morlac/helios_display/FreeCAD/HeliosDisplayStand-Proto_RaspiBody.stl

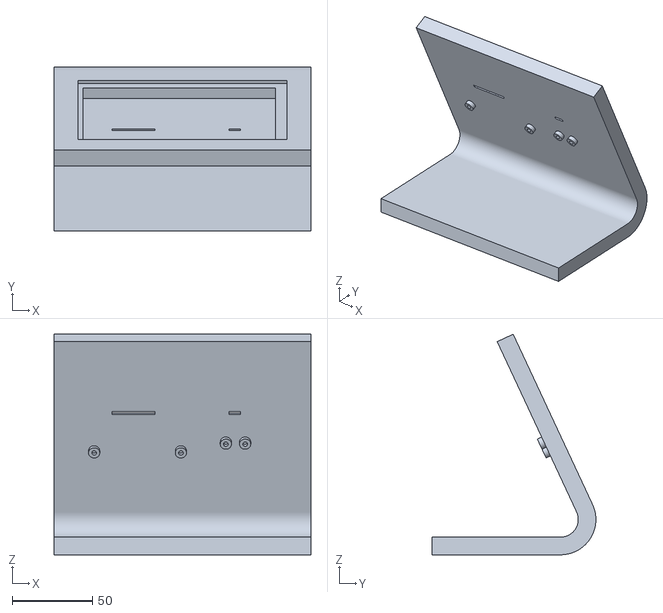
[picture p1: CAD file, 2022-06-07]
FreeCAD/HeliosDisplayStand-Proto_RaspiBody.stl
160.0 x 102.0 x 137.3
