morlac/helios_display/FreeCAD/HeliosDisplayStand.FCStd

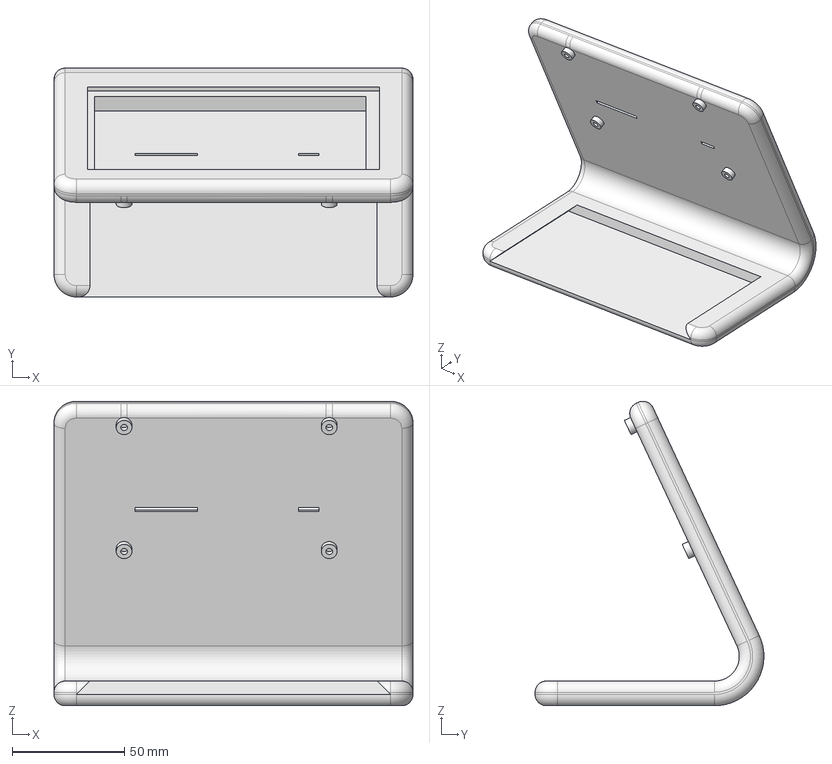
[picture p2: CAD file, 2022-06-07]
FreeCAD/HeliosDisplayStand.FCStd
160.0 x 102.0 x 135.7 mm
