morlac/helios_display/FreeCAD/HeliosDisplayStand-Electronics-BaseRaspi_2+.stl

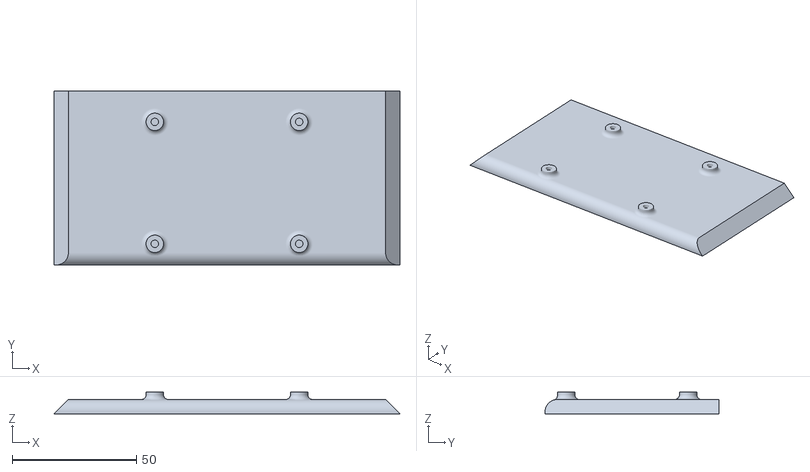
[picture p3: CAD file, 2022-06-07]
FreeCAD/HeliosDisplayStand-Electronics-BaseRaspi_2+.stl
139.0 x 69.9 x 8.80
