morlac/helios_display/KiCAD/Download_WE-PD_1280_STP (rev1).stp

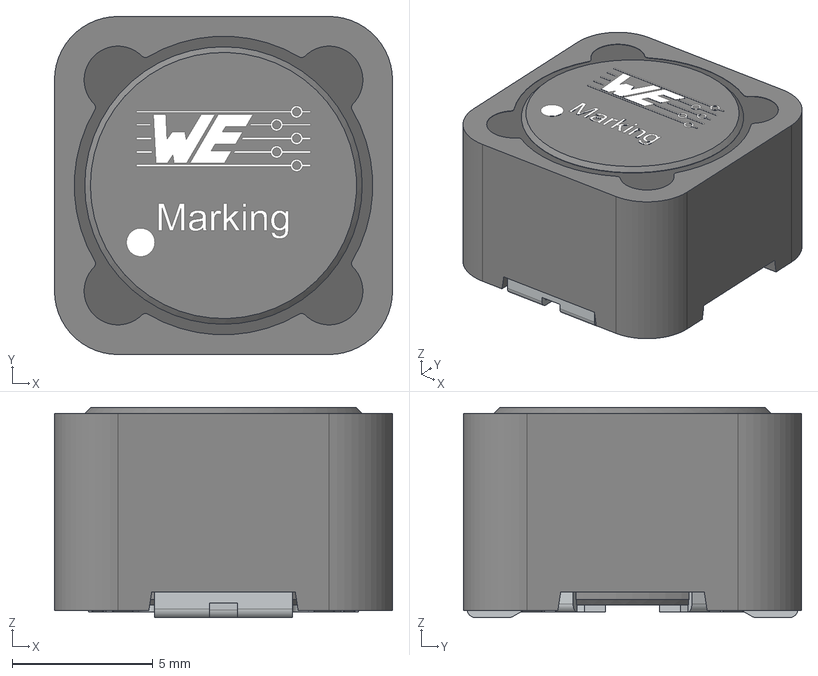
[picture p4: CAD file, 2022-06-07]
KiCAD/Download_WE-PD_1280_STP (rev1).stp
12.0 x 12.0 x 7.46 mm
Core
ShieldRing
Glue
Leadframe
