morlac/helios_display/FreeCAD/TestRig.FCStd

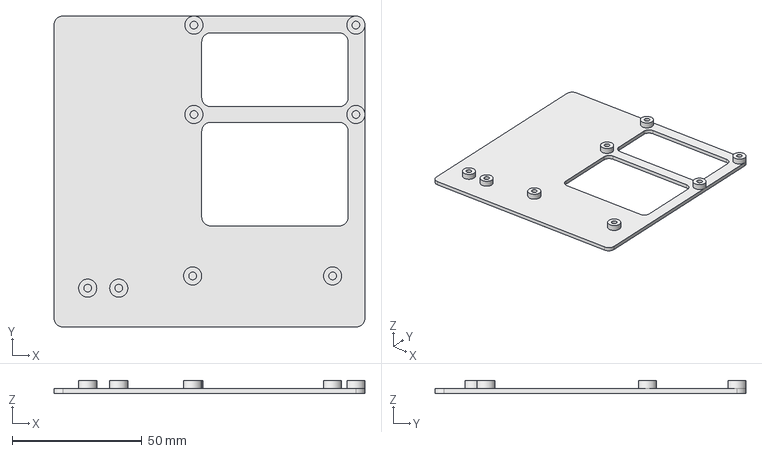
[picture p5: CAD file, 2022-02-08]
FreeCAD/TestRig.FCStd
120.0 x 120.0 x 5.00 mm
