morlac/helios_display/FreeCAD/TestRig-PartBasePlate.stl

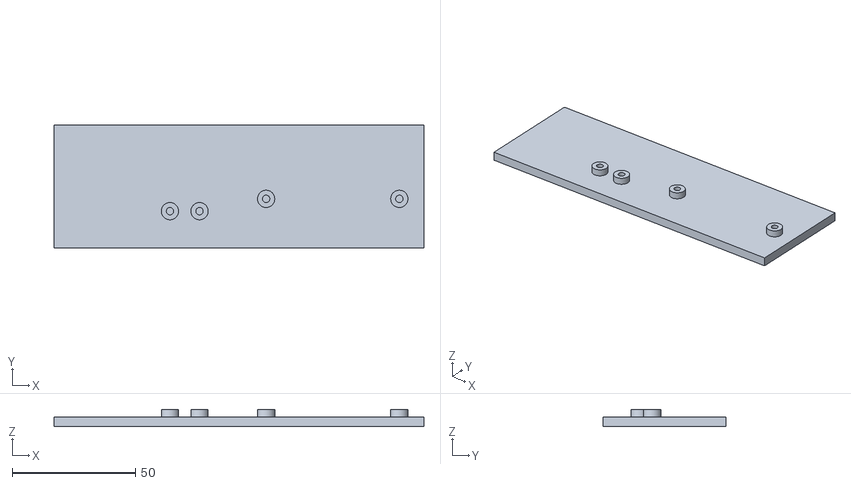
[picture p6: CAD file, 2022-02-08]
FreeCAD/TestRig-PartBasePlate.stl
150.0 x 50.0 x 7.00
