morlac/helios_display/KiCAD/687145149022 (rev1).stp

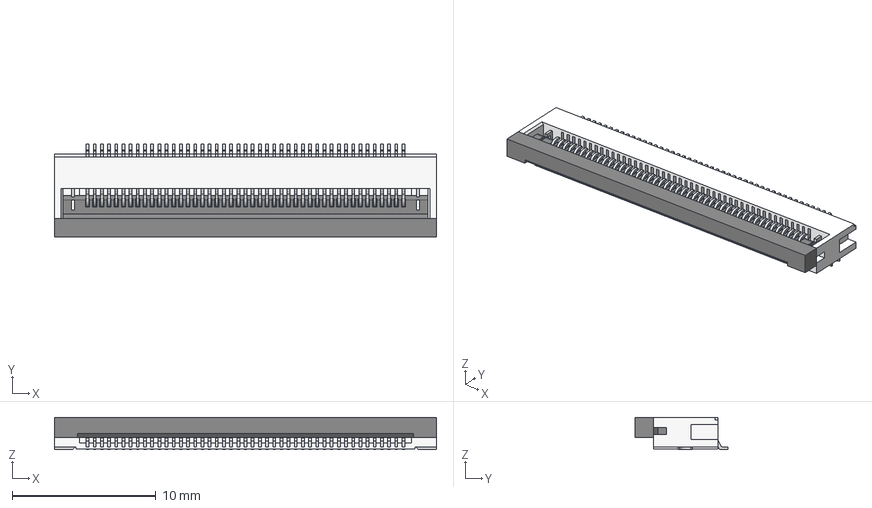
[picture p7: CAD file, 2022-06-07]
KiCAD/687145149022 (rev1).stp
26.6 x 6.50 x 2.25 mm
6871xx149022_Pin x 45
6871xx149022_Patte
6871xx149022_Patte2
687145149022_Actuator
