morlac/helios_display/KiCAD/687106149022 (rev1).stp

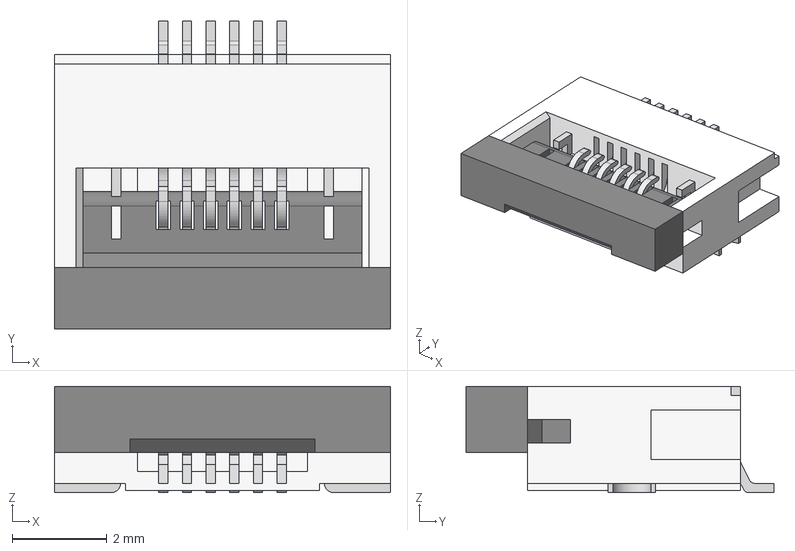
[picture p8: CAD file, 2022-06-07]
KiCAD/687106149022 (rev1).stp
7.10 x 6.50 x 2.25 mm
6871xx149022_Pin x 6
6871xx149022_Patte
6871xx149022_Patte2
687106149022_Actuator
