morlac/helios_display/(list of files, cad)

Other CAD files:
FreeCAD/HeliosDisplayStand-Electronics-BaseRaspi_Zero.stl
FreeCAD/HeliosDisplayStand-StandBody.stl
FreeCAD/TestRig-DevBoard.stl
FreeCAD/HeliosDisplayStand-Proto_Raspi.stl
