morlac/helios_display/(list of files, drawings)

Other design files:
KiCAD/Helios-Display.dsn
