morlac/helios_display/KiCAD/Helios-Display.kicad_pcb

## KiCad design KiCAD/Helios-Display.kicad_pcb (2022-06-07)

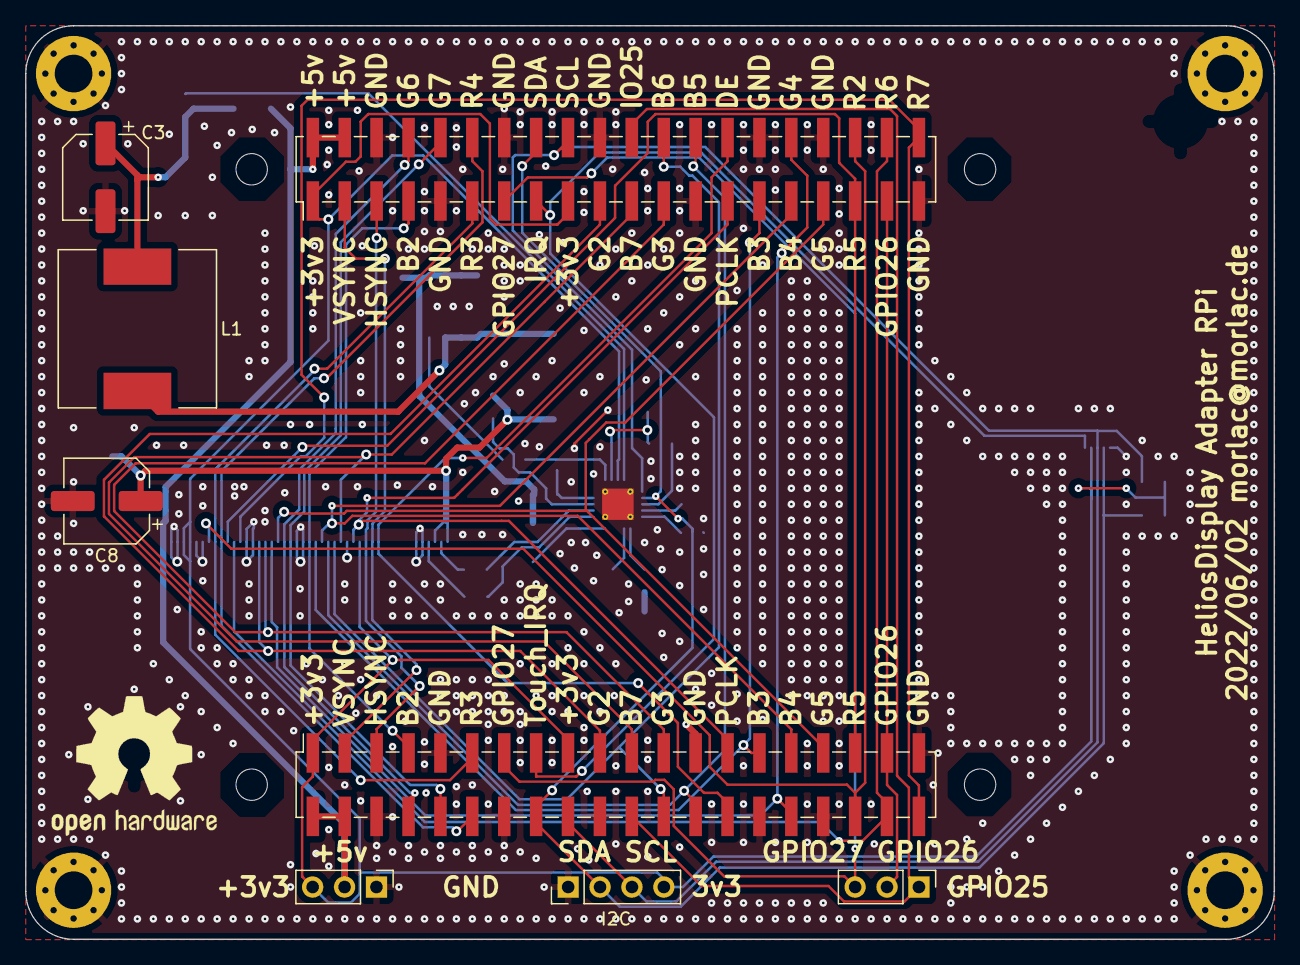
[picture p9: board Helios-Display.kicad_pcb from above]

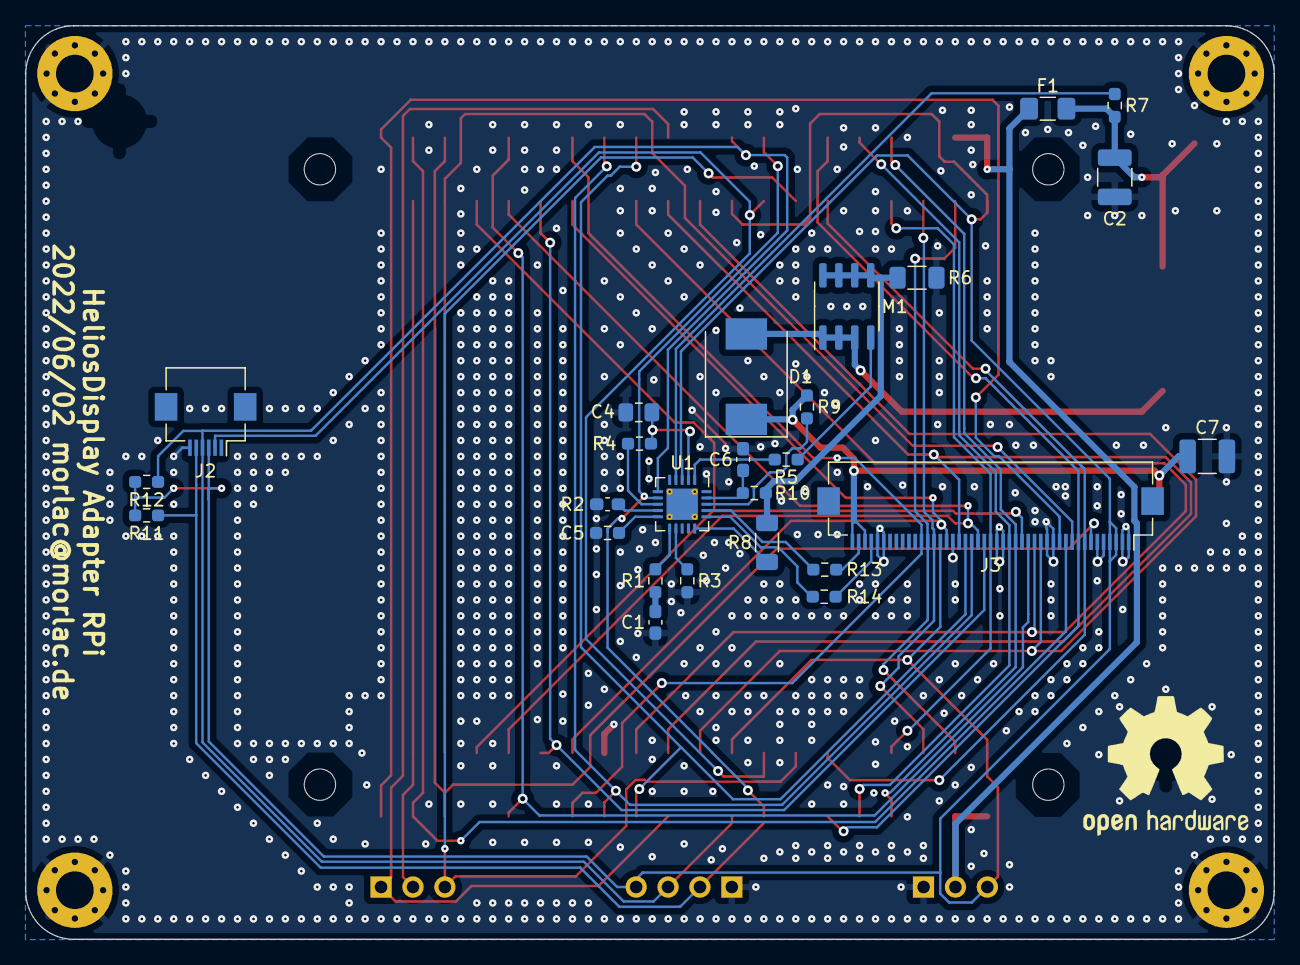
[picture p10: board Helios-Display.kicad_pcb from below]

Board: 2 copper layers, 99.4 x 72.7 mm, 44 parts (27 on the bottom side), 52 nets.

Parts:
C1: 470nF; C_0603_1608Metric_Pad1.08x0.95mm_HandSolder
C2: 4.7uF/16V; C_1210_3225Metric_Pad1.33x2.70mm_HandSolder
C3: 220uF/16V; CP_Elec_6.3x3
C4: 0.47uF; C_0805_2012Metric_Pad1.18x1.45mm_HandSolder
C5: 100nF; C_0603_1608Metric_Pad1.08x0.95mm_HandSolder
C6: NC; C_0603_1608Metric_Pad1.08x0.95mm_HandSolder
C7: 4.7uF/25V; C_1210_3225Metric_Pad1.33x2.70mm_HandSolder
C8: 22uF/25V; CP_Elec_6.3x3
D1: B360; D_SMC
F1: Fuse; Fuse_1206_3216Metric_Pad1.42x1.75mm_HandSolder
H1, H2, H3, H4: MountingHole_Pad; MountingHole_3mm_Pad_Via
H5, H6, H7, H8: MountingHoleRaspi; MountingHole_2.5mm
J1, J8: Raspberry_Pi_2_3; PinHeader_2x20_P2.54mm_Vertical_SMD
J2: FFC_ST1633 (Touch); Hirose_FH12-6S-0.5SH_1x06-1MP_P0.50mm_Horizontal
J3: FFC_LCD; Hirose_FH12-45S-0.5SH_1x45-1MP_P0.50mm_Horizontal
J4: Power; PinHeader_1x03_P2.54mm_Vertical
J6: I2C; PinHeader_1x04_P2.54mm_Vertical
J7: GPIO; PinHeader_1x03_P2.54mm_Vertical
L1: 33uH/3.5A; L_12x12mm_H8mm
M1: AM4490N; SOIC-8_3.9x4.9mm_P1.27mm
OSHW_F: OSHW-Logo2_14.6x12mm_SilkScreen
OSJW_B: OSHW-Logo2_14.6x12mm_SilkScreen
R1: 270; R_0603_1608Metric_Pad0.98x0.95mm_HandSolder
R2, R4: 100k; R_0603_1608Metric_Pad0.98x0.95mm_HandSolder
R3: R; R_0603_1608Metric_Pad0.98x0.95mm_HandSolder
R5: 10; R_0603_1608Metric_Pad0.98x0.95mm_HandSolder
R6: 50m; R_1206_3216Metric_Pad1.30x1.75mm_HandSolder
R7, R9, R10, R13, R14: 0; R_0603_1608Metric_Pad0.98x0.95mm_HandSolder
R8: NC; R_1206_3216Metric_Pad1.30x1.75mm_HandSolder
R11, R12: 50; R_0603_1608Metric_Pad0.98x0.95mm_HandSolder
U1: MP3385A; QFN-20-1EP_4x4mm_P0.5mm_EP2.5x2.5mm_ThermalVias

Connections:
+3V3: J1.1 (3V3), J1.17 (3V3), J2.3, J3.3, J3.4, J3.31, J4.3, J6.4, J8.1 (3V3), J8.17 (3V3), R11.2, R12.2, U1.3 (EN)
+5V: F1.1, J1.2 (5V), J1.4 (5V), J4.2, J8.2 (5V), J8.4 (5V)
/GPIO25: J1.22 (GPIO25), J7.1, J8.22 (GPIO25)
/GPIO26: J1.37 (GPIO26), J7.2, J8.37 (GPIO26)
/GPIO27: J1.13 (GPIO27), J7.3, J8.13 (GPIO27)
/GPIO_SCL: J1.18 (GPIO24), J2.4, J6.3, J8.18 (GPIO24), R12.1, U1.6 (SCL)
/GPIO_SDA: J1.16 (GPIO23), J2.5, J6.2, J8.16 (GPIO23), R11.1, U1.7 (SDA)
/LCD_B_{2}: J1.7 (GCLK0/GPIO4), J3.23, J8.7 (GCLK0/GPIO4)
/LCD_B_{3}: J1.29 (GCLK1/GPIO5), J3.24, J8.29 (GCLK1/GPIO5)
/LCD_B_{4}: J1.31 (GCLK2/GPIO6), J3.25, J8.31 (GCLK2/GPIO6)
/LCD_B_{5}: J1.26 (~CE1/GPIO7), J3.26, J8.26 (~CE1/GPIO7)
/LCD_B_{6}: J1.24 (~CE0/GPIO8), J3.27, J8.24 (~CE0/GPIO8)
/LCD_B_{7}: J1.21 (MISO0/GPIO9), J3.28, J8.21 (MISO0/GPIO9)
/LCD_DE: J1.28 (ID_SC/GPIO1), J3.34, J8.28 (ID_SC/GPIO1)
/LCD_G_{2}: J1.19 (MOSI0/GPIO10), J3.15, J8.19 (MOSI0/GPIO10)
/LCD_G_{3}: J1.23 (SCLK0/GPIO11), J3.16, J8.23 (SCLK0/GPIO11)
/LCD_G_{4}: J1.32 (PWM0/GPIO12), J3.17, J8.32 (PWM0/GPIO12)
/LCD_G_{5}: J1.33 (PWM1/GPIO13), J3.18, J8.33 (PWM1/GPIO13)
/LCD_G_{6}: J1.8 (GPIO14/TXD), J3.19, J8.8 (GPIO14/TXD)
/LCD_G_{7}: J1.10 (GPIO15/RXD), J3.20, J8.10 (GPIO15/RXD)
/LCD_HSYNC: J1.5 (SCL/GPIO3), J3.32, J8.5 (SCL/GPIO3)
/LCD_LED_A1: C7.1, C8.1, D1.1 (K), J3.43, J3.45, R9.2
/LCD_LED_C1: J3.42, R14.2
/LCD_LED_C2: J3.44, R13.2
/LCD_PCLK: J1.27 (ID_SD/GPIO0), J3.30, J8.27 (ID_SD/GPIO0)
/LCD_R_{2}: J1.36 (GPIO16), J3.7, J8.36 (GPIO16)
/LCD_R_{3}: J1.11 (GPIO17), J3.8, J8.11 (GPIO17)
/LCD_R_{4}: J1.12 (GPIO18/PWM0), J3.9, J8.12 (GPIO18/PWM0)
/LCD_R_{5}: J1.35 (GPIO19/MISO1), J3.10, J8.35 (GPIO19/MISO1)
/LCD_R_{6}: J1.38 (GPIO20/MOSI1), J3.11, J8.38 (GPIO20/MOSI1)
/LCD_R_{7}: J1.40 (GPIO21/SCLK1), J3.12, J8.40 (GPIO21/SCLK1)
/LCD_VSYNC: J1.3 (SDA/GPIO2), J3.33, J8.3 (SDA/GPIO2)
/ST1633_IRQ: J1.15 (GPIO22), J2.2, J8.15 (GPIO22)
/VCC: C4.2, R4.1, U1.2 (VCC)
GNDA: C1.2, C2.2, C3.2, C4.1, C5.2, C6.2, C7.2, C8.2, H1.1, H2.1, H3.1, H4.1, J1.6 (GND), J1.9 (GND), J1.14 (GND), J1.20 (GND), J1.25 (GND), J1.30 (GND), J1.34 (GND), J1.39 (GND), J2.6, J3.1, J3.2, J3.5, J3.6, J3.13, J3.14, J3.21, J3.22, J3.29, J3.40, J3.41, J4.1, J6.1, J8.6 (GND), J8.9 (GND), J8.14 (GND), J8.20 (GND), J8.25 (GND), J8.30 (GND), J8.34 (GND), J8.39 (GND), R2.1, R3.2, R6.2, U1.21 (GND)
unnamed: C1.1, R1.2
unnamed: C2.1, C3.1, F1.2, L1.1, R7.1
unnamed: C5.1, U1.9 (LPF)
unnamed: C6.1, R10.1, U1.19 (IS)
unnamed: D1.2 (A), L1.2, M1.1 (D), M1.2 (D), M1.3 (D)
unnamed: M1.4 (G), R5.2
unnamed: M1.5 (S), M1.6 (S), M1.7 (S), M1.8 (S), R6.1, R8.2, R10.2
unnamed: R1.1, U1.11 (COMP)
unnamed: R2.2, U1.10 (OSC)
unnamed: R3.1, U1.12 (ISET)
unnamed: R4.2, U1.8 (FT)
unnamed: R5.1, U1.1 (DRV)
unnamed: R7.2, U1.4 (VIN)
unnamed: R8.1, U1.15 (PGND)
unnamed: R14.1, U1.16 (LED2)
unnamed: R13.1, U1.17 (LED1)
unnamed: R9.1, U1.18 (OVP)
