morlac/helios_display/(commit log)

2022-02-08 inital data commit
    [HeliosDisplayStand-Proto_Raspi.stl, HeliosDisplayStand.FCStd, TestRig-DevBoard.stl, TestRig-PartBasePlate.stl, TestRig.FCStd, config.txt, heliosdisplay_config.txt]
2022-03-13 added adapter-holder
    [HeliosDisplayStand.FCStd]
2022-03-15 updated some measures
    [HeliosDisplayStand.FCStd]
2022-04-18 KiCAD initial commit
    [Helios-Display.kicad_pcb, Helios-Display.kicad_sch]
2022-06-07 updated FreeCAD files
    [HeliosDisplayStand-Electronics-BaseRaspi_2+.stl, HeliosDisplayStand-Electronics-BaseRaspi_Zero.stl, HeliosDisplayStand-Proto_RaspiBody.stl, HeliosDisplayStand-StandBody.stl, HeliosDisplayStand.FCStd]
2022-06-07 updated KiCAD files
    [687106149022 (rev1).stp, 687145149022 (rev1).stp, Download_WE-PD_1280_STP (rev1).stp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]
2022-06-07 current version of Helios-Display.wrl
